RobertWeber1/ThermoControl/board/phase_angle_control/phase_angle_control/lcsc/CC0603JRNPO9BN103.step

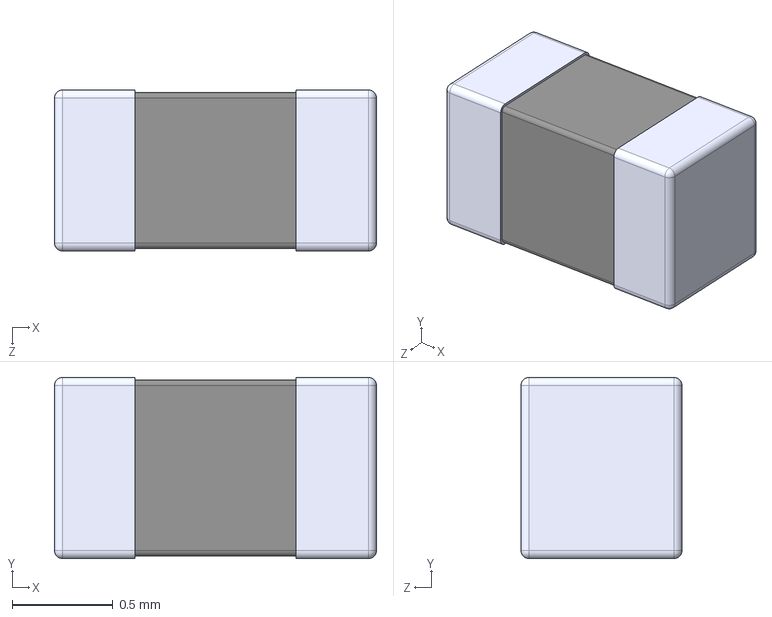
[picture p1: CAD file, 2021-10-10]
board/phase_angle_control/phase_angle_control/lcsc/CC0603JRNPO9BN103.step
1.60 x 0.9 x 0.8 mm
