RobertWeber1/ThermoControl/board/phase_angle_control/phase_angle_control/lcsc/MAX31855KASA_T.step

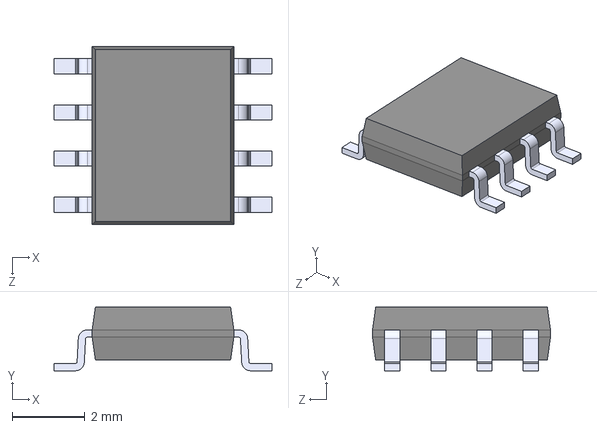
[picture p2: CAD file, 2021-10-10]
board/phase_angle_control/phase_angle_control/lcsc/MAX31855KASA_T.step
6.00 x 1.75 x 4.90 mm
