RobertWeber1/ThermoControl/board/phase_angle_control/phase_angle_control/phase_angle_control.kicad_pcb

## KiCad design board/phase_angle_control/phase_angle_control/phase_angle_control.kicad_pcb (2021-11-07)

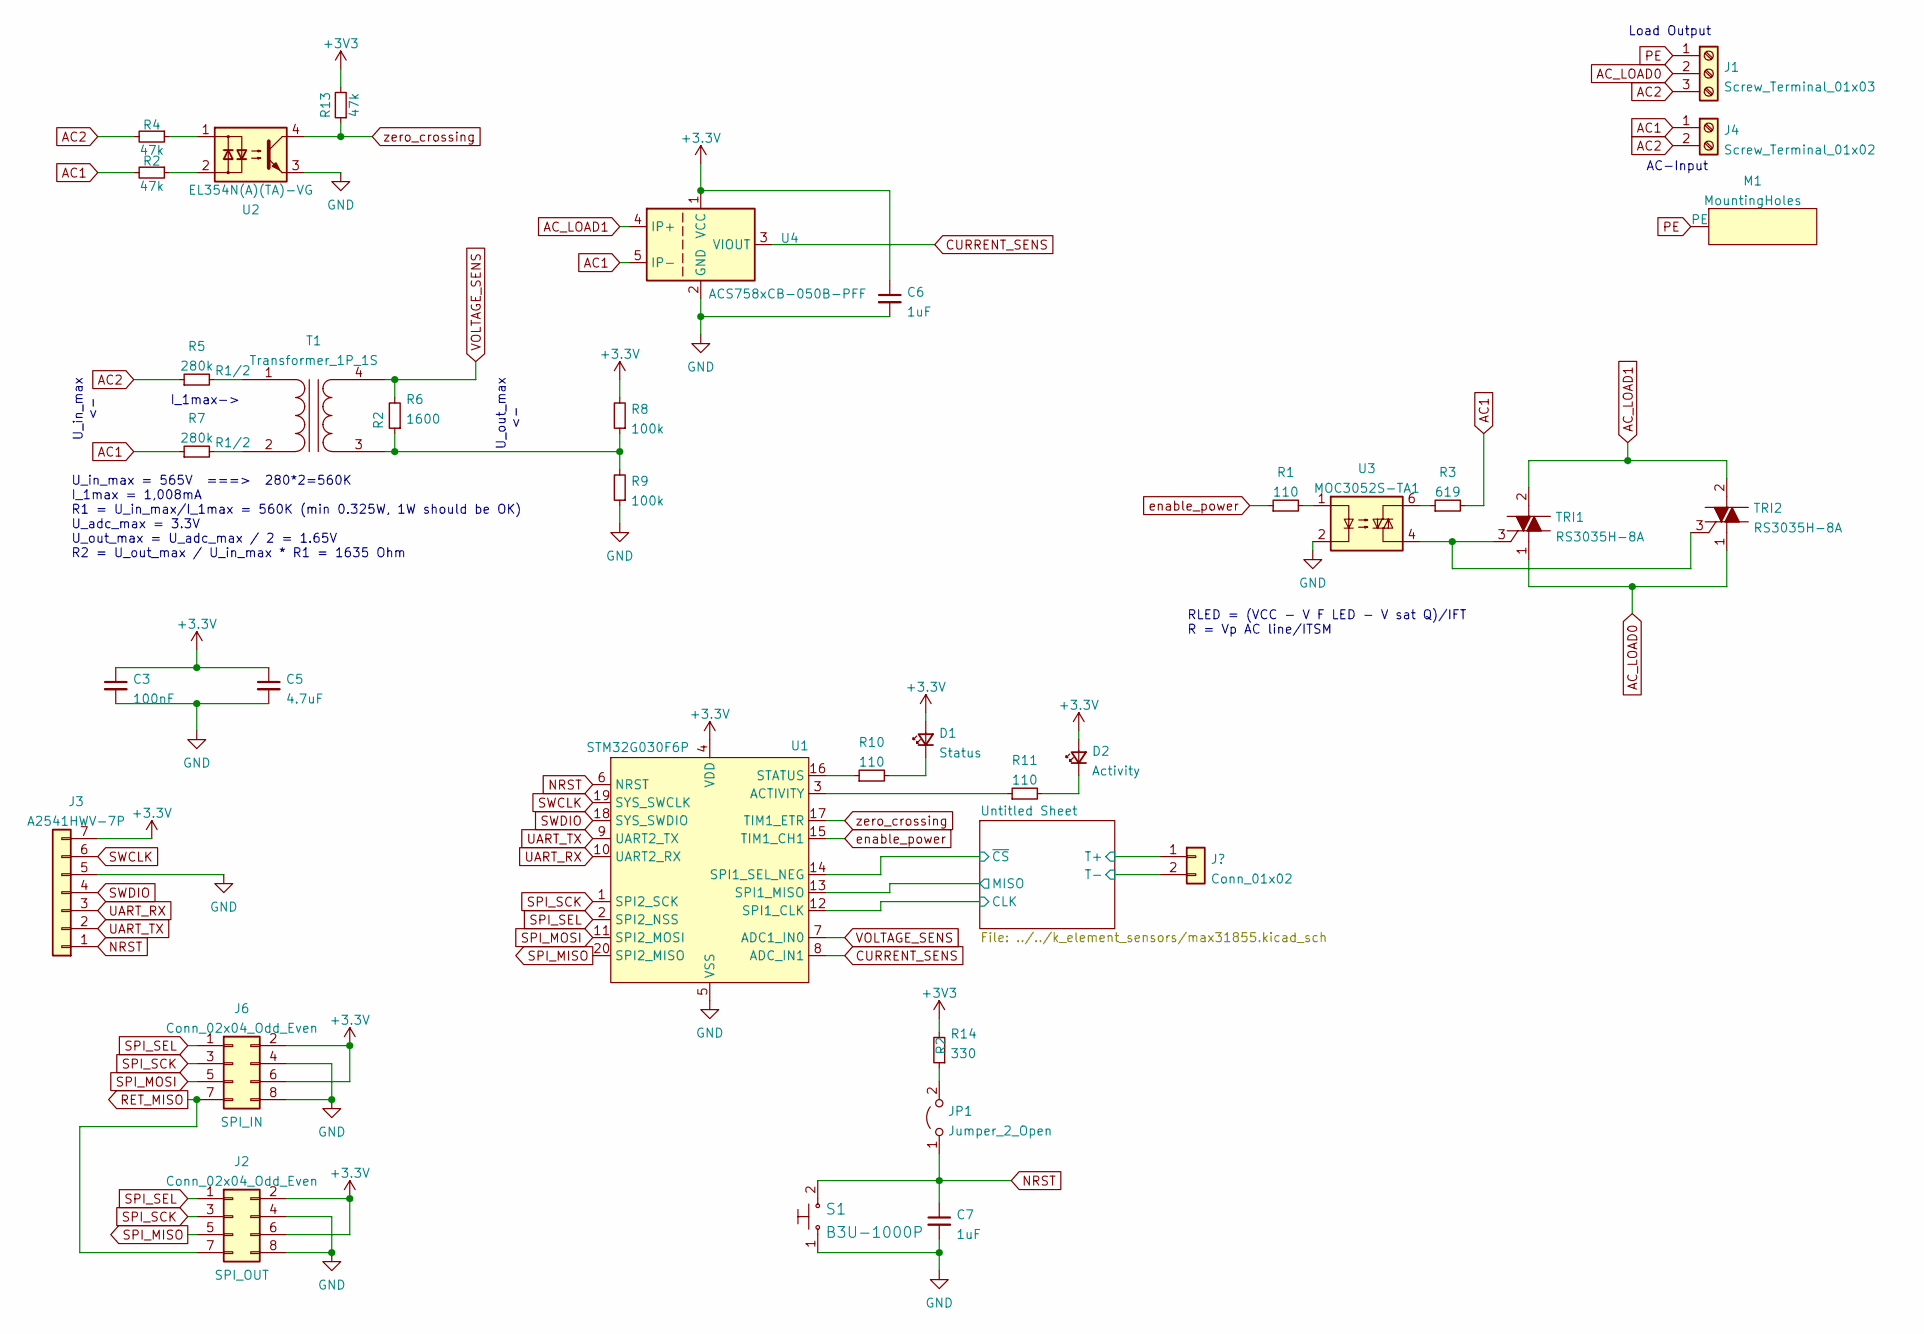
[picture p3: schematic phase_angle_control.kicad_sch]

Parts:
C3: 100nF; C_0603_1608Metric_Pad1.08x0.95mm_HandSolder; LCSC Part# C191538
C5: 4.7uF; C_0603_1608Metric_Pad1.08x0.95mm_HandSolder; LCSC Part# C651001
C6, C7: 1uF; C_0603_1608Metric_Pad1.08x0.95mm_HandSolder; LCSC Part# C393692
D1: Status; LED_0603_1608Metric_Pad1.05x0.95mm_HandSolder; LCSC Part# C273616
D2: Activity; LED_0603_1608Metric_Pad1.05x0.95mm_HandSolder; LCSC Part# C192667
J1: Screw_Terminal_01x03; KF206B-7.5-3P; LCSC Part# C475240
J2, J6: Conn_02x04_Odd_Even; PinHeader_2x04_P2.54mm_Horizontal; LCSC Part# C358706
J3: A2541HWV-7P; PinSocket_1x07_P2.54mm_Vertical; LCSC Part# C225504
J4: Screw_Terminal_01x02; KF206B-7.5-2P; LCSC Part# C475239
JP1: Jumper_2_Open; SolderJumper-2_P1.3mm_Open_RoundedPad1.0x1.5mm
M1: MountingHoles; MountingHolesPE
R1, R10, R11: 110; R_0603_1608Metric_Pad0.98x0.95mm_HandSolder; LCSC Part# C203247
R2: 47k; R_1206_3216Metric_Pad1.30x1.75mm_HandSolder; LCSC Part# C104822
R3: 619; R_1206_3216Metric_Pad1.30x1.75mm_HandSolder; LCSC Part# C247212
R4: 47k; R_1206_3216Metric_Pad1.30x1.75mm_HandSolder
R5, R7: 280k; R_1210_3225Metric_Pad1.30x2.65mm_HandSolder; LCSC Part# C422336
R6: 1600; R_0603_1608Metric_Pad0.98x0.95mm_HandSolder; LCSC Part# C186398
R8, R9: 100k; R_0603_1608Metric_Pad0.98x0.95mm_HandSolder; LCSC Part# C203223
R13: 47k; R_0603_1608Metric_Pad0.98x0.95mm_HandSolder; LCSC Part# C427281
R14: 330; R_0603_1608Metric_Pad0.98x0.95mm_HandSolder; LCSC Part# C186383
S1: B3U-1000P; Switch_Tactile_SMD_B3U-1000P; MPN B3U-1000P; Digi-Key_PN SW1020CT-ND
T1: Transformer_1P_1S; Transformer_ZMPT107-1; LCSC Part# C125191
TRI1, TRI2: RS3035H-8A; TO-220-3; MPN BTA16-600BWRG; LCSC Part# C246522
U1: STM32G030F6P; SSOP-20_4.4x6.5mm_P0.65mm; LCSC Part# C724040
U2: EL354N(A)(TA)-VG; SMDIP-4_W7.62mm; LCSC Part# C146213
U3: MOC3052S-TA1; DIP-6_W8.89mm_SMDSocket_LongPads; LCSC Part# C115471
U4: ACS758xCB-050B-PFF; Allegro_CB_PFF; LCSC Part# C73426

Connections:
/Untitled Sheet/CLK: U1.12 (SPI1_CLK); also elsewhere on the board
/Untitled Sheet/MISO: U1.13 (SPI1_MISO); also elsewhere on the board
/Untitled Sheet/~CS: U1.14 (SPI1_SEL_NEG); also elsewhere on the board
AC1: J4.1, R2.2, R3.2, R7.1, U4.5 (IP-)
AC2: J1.3, J4.2, R4.2, R5.1
AC_LOAD0: J1.2, TRI1.1 (A1), TRI2.1 (A1)
AC_LOAD1: TRI1.2 (A2), TRI2.2 (A2), U4.4 (IP+)
CURRENT_SENS: U1.8 (ADC_IN1), U4.3 (VIOUT)
GND: C3.2, C5.2, C6.2, C7.2, J2.4, J2.8, J3.5, J6.4, J6.8, R9.1, S1.1, U1.5 (VSS), U2.3, U3.2, U4.2 (GND); also elsewhere on the board
NRST: C7.1, J3.1, JP1.1 (A), S1.2, U1.6 (NRST)
unnamed: D1.1 (K), R10.2
unnamed: JP1.2 (B), R14.1
unnamed: R1.2, U3.1
unnamed: R2.1, U2.2
unnamed: R3.1, U3.6
unnamed: R4.1, U2.1
unnamed: R5.2, T1.1 (AA)
unnamed: R6.1, R8.1, R9.2, T1.3 (SA)
unnamed: R7.2, T1.2 (AB)
unnamed: R10.1, U1.16 (STATUS)
unnamed: R11.1, U1.3 (ACTIVITY)
unnamed: D2.1 (K), R11.2
unnamed: TRI1.3 (G), TRI2.3 (G), U3.4
PE: J1.1, M1.1 (PE)
RET_MISO: J2.7, J6.7
SPI_MISO: J2.5, U1.20 (SPI2_MISO)
SPI_MOSI: J6.5, U1.11 (SPI2_MOSI)
SPI_SCK: J2.3, J6.3, U1.1 (SPI2_SCK)
SPI_SEL: J2.1, J6.1, U1.2 (SPI2_NSS)
SWCLK: J3.6, U1.19 (SYS_SWCLK)
SWDIO: J3.4, U1.18 (SYS_SWDIO)
UART_RX: J3.3, U1.10 (UART2_RX)
UART_TX: J3.2, U1.9 (UART2_TX)
VOLTAGE_SENS: R6.2, T1.4 (SB), U1.7 (ADC1_IN0)
enable_power: R1.1, U1.15 (TIM1_CH1)
zero_crossing: R13.1, U1.17 (TIM1_ETR), U2.4

Notes on the sheet:
U_in_max = 565V ===> 280*2=560K I_1max = 1,008mA R1 = U_in_max/I_1max = 560K (min 0.325W, 1W should be OK) U_adc_max = 3.3V U_out_max = U_adc_max / 2 = 1.65V R2 = U_out_max / U_in_max * R1 = 1635 Ohm
U_in_max <-
I_1max->
U_out_max <-
RLED = (VCC - V F LED - V sat Q)/IFT R = Vp AC line/ITSM
Load Output
AC-Input

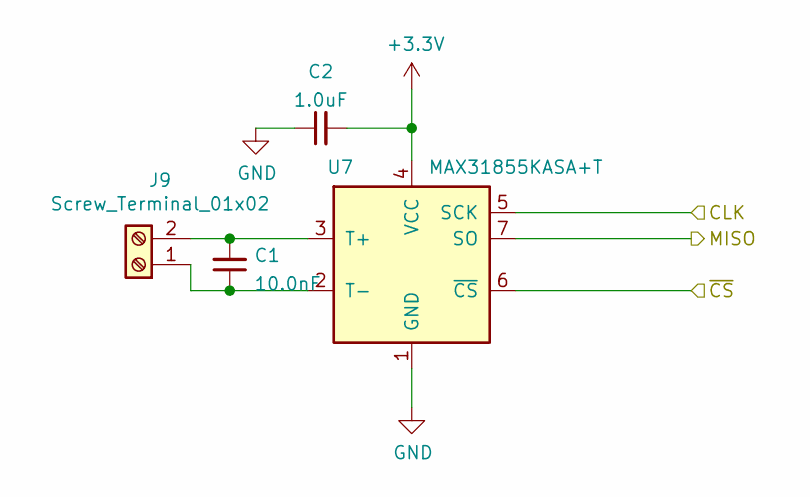
[picture p4: schematic max31855.kicad_sch]

Parts:
C1: 10.0nF; C_0603_1608Metric_Pad1.08x0.95mm_HandSolder
C2: 1.0uF; C_0603_1608Metric_Pad1.08x0.95mm_HandSolder
J9: Screw_Terminal_01x02; con_A123829-ND‎; LCSC Part # C474892
U7: MAX31855KASA+T; SOIC-8_3.9x4.9mm_P1.27mm; LCSC Part # C52028

Connections:
/Untitled Sheet/CLK: U7.5 (SCK); also elsewhere on the board
/Untitled Sheet/MISO: U7.7 (SO); also elsewhere on the board
/Untitled Sheet/~CS: U7.6 (~CS); also elsewhere on the board
GND: C2.1, U7.1 (GND); also elsewhere on the board
unnamed: C1.1, J9.1, U7.2 (T-)
unnamed: C1.2, J9.2, U7.3 (T+)

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
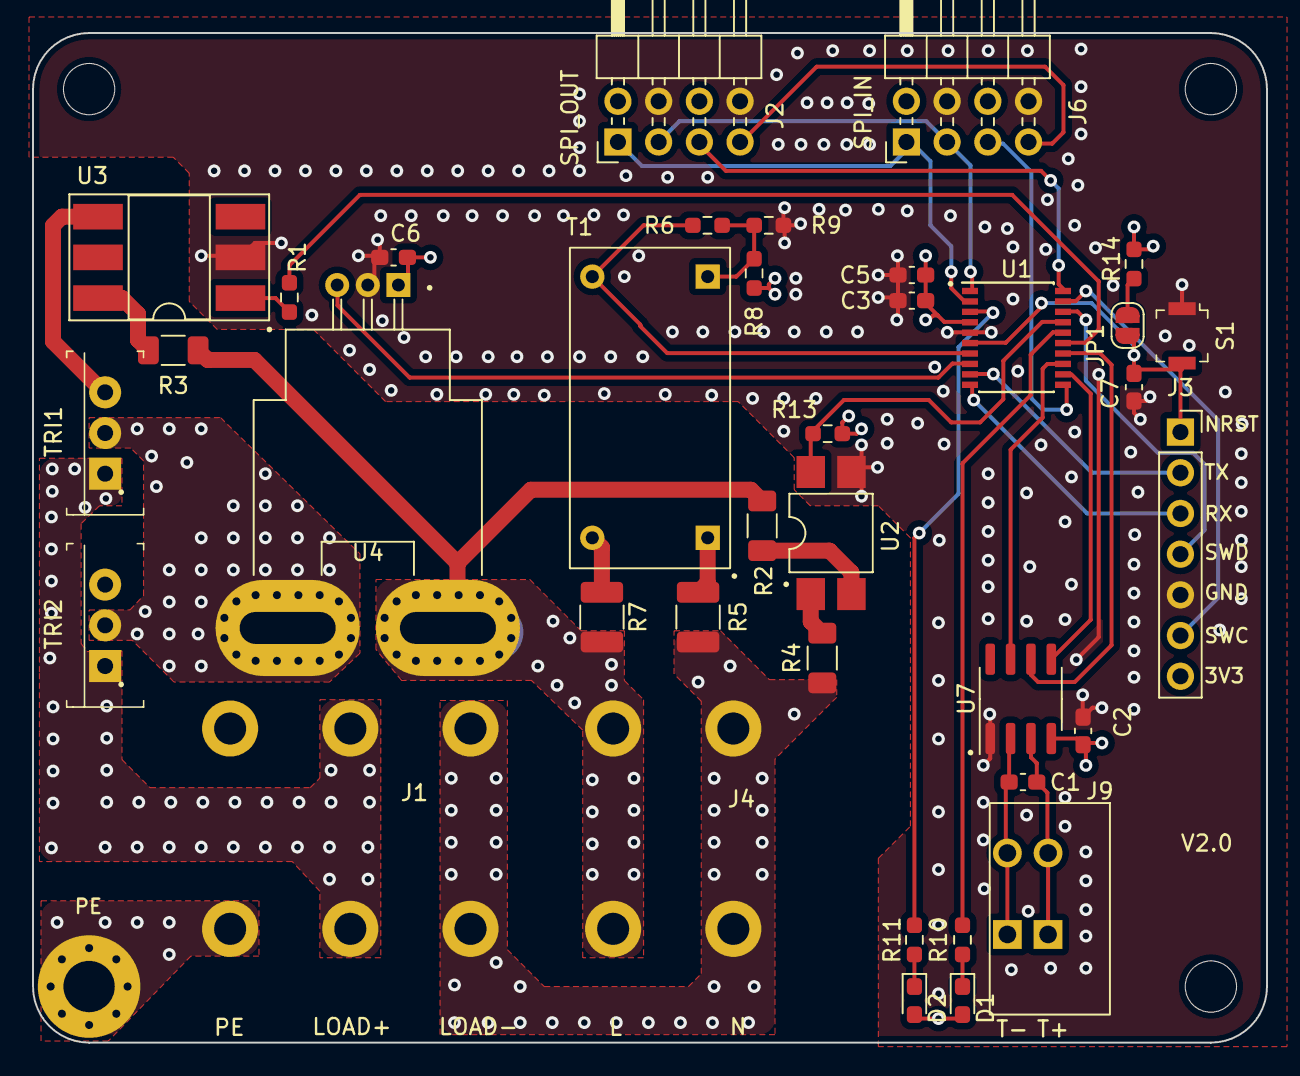
[picture p5: board phase_angle_control.kicad_pcb from above]

Board: 4 copper layers, 77.0 x 63.0 mm, 38 parts (0 on the bottom side), 39 nets.
