RobertWeber1/ThermoControl/board/brain_board/brain_board.kicad_pcb

## KiCad design board/brain_board/brain_board.kicad_pcb (2021-11-07)

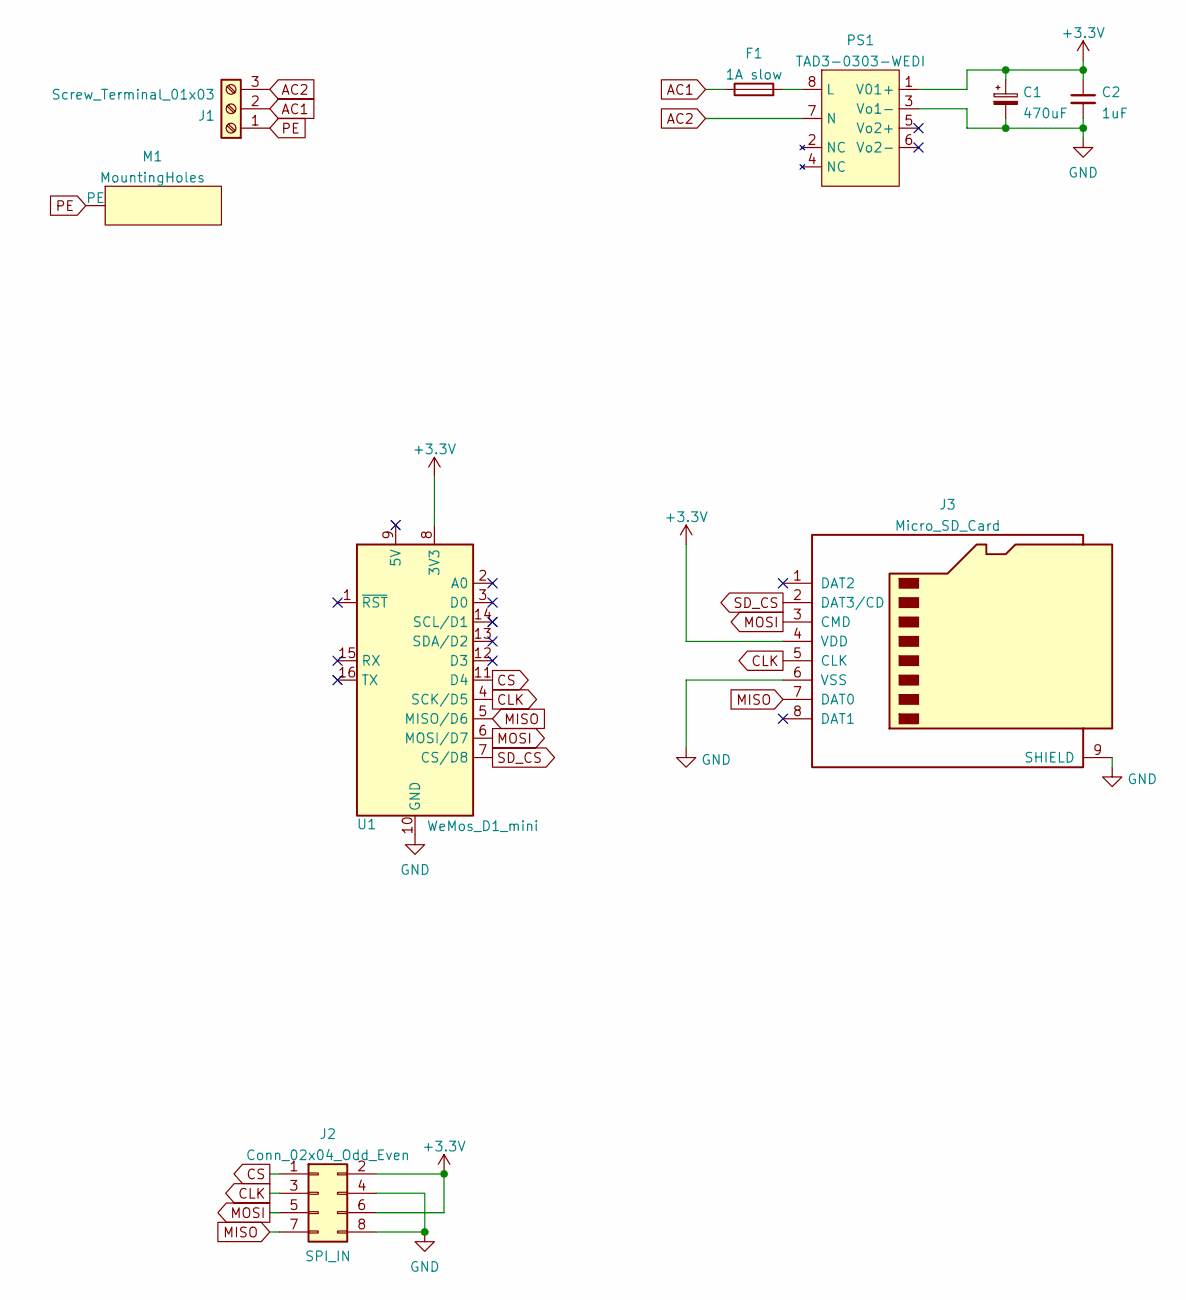
[picture p6: schematic brain_board.kicad_sch]

Parts:
C1: 470uF; CP_Radial_D8.0mm_P3.50mm; LCSC Part# C840136
C2: 1uF; C_Disc_D4.3mm_W1.9mm_P5.00mm; LCSC Part# C444742
F1: 1A slow; Fuse_2410; LCSC Part# C136380
J1: Screw_Terminal_01x03; KF206B-7.5-3P; LCSC Part# C475240
J2: Conn_02x04_Odd_Even; PinHeader_2x04_P2.54mm_Horizontal; LCSC Part# C358706
J3: Micro_SD_Card; micro_sd_slot; LCSC Part# C341095
M1: MountingHoles; MountingHolesPE
PS1: TAD3-0303-WEDI; LCSC Part# C695893
U1: WeMos_D1_mini; WEMOS_D1_mini_light

Connections:
+3V3: C1.1, C2.1, J2.2, J2.6, J3.4 (VDD), PS1.1 (V01+), U1.8 (3V3)
AC1: F1.1, J1.2
AC2: J1.3, PS1.7 (N)
CLK: J2.3, J3.5 (CLK), U1.4 (SCK/D5)
CS: J2.1, U1.11 (D4)
GND: C1.2, C2.2, J2.4, J2.8, J3.6 (VSS), J3.9 (SHIELD), PS1.3 (Vo1-), U1.10 (GND)
MISO: J2.7, J3.7 (DAT0), U1.5 (MISO/D6)
MOSI: J2.5, J3.3 (CMD), U1.6 (MOSI/D7)
unnamed: F1.2, PS1.8 (L)
PE: J1.1, M1.1 (PE)
SD_CS: J3.2 (DAT3/CD), U1.7 (CS/D8)

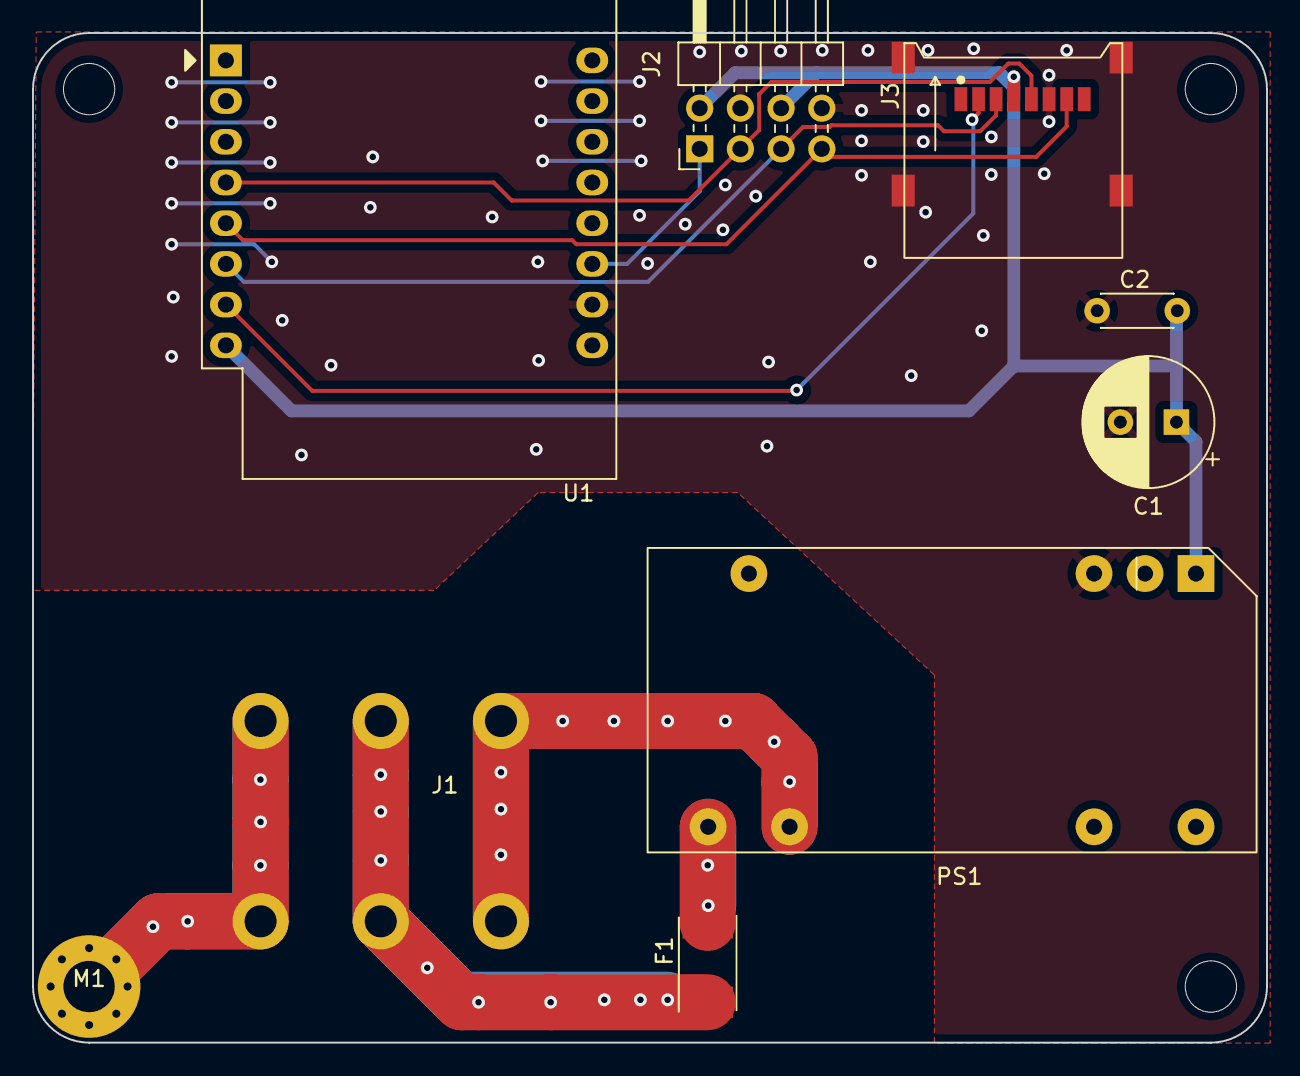
[picture p7: board brain_board.kicad_pcb from above]

Board: 2 copper layers, 77.0 x 63.0 mm, 9 parts (0 on the bottom side), 11 nets.
