RobertWeber1/ThermoControl/board/k_element_sensors/Thermo.kicad_pcb

## KiCad design board/k_element_sensors/Thermo.kicad_pcb (2021-05-06)

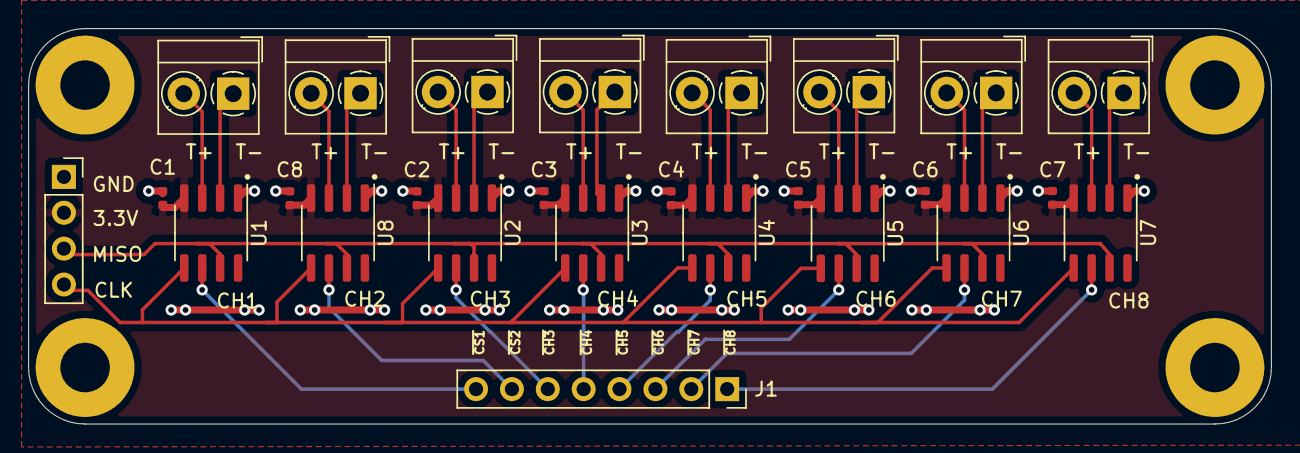
[picture p8: board Thermo.kicad_pcb from above]

Board: 2 copper layers, 88.0 x 28.0 mm, 27 parts (0 on the bottom side), 28 nets.

Parts:
C1, C2, C3, C4, C5, C6, C7, C8: 0402_1.0uF__105_10%_25V; C_0402_1005Metric
H1: MountingHoles; MountingHole_pattern
J1: Conn_01x08; PinSocket_1x08_P2.54mm_Vertical
J2: Conn_01x04; PinSocket_1x04_P2.54mm_Vertical
J3, J4, J5, J6, J7, J8, J9, J10: Screw_Terminal_01x02; TerminalBlock_MetzConnect_Type059_RT06302HBWC_1x02_P3.50mm_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
U1, U2, U3, U4, U5, U6, U7, U8: MAX31855KASA+T; SOIC-8_3.9x4.9mm_P1.27mm

Connections:
+3V3: C1.2, C2.2, C3.2, C4.2, C5.2, C6.2, C7.2, C8.2, J2.2, U1.4, U2.4, U3.4, U4.4, U5.4, U6.4, U7.4, U8.4
/max31855/CLK: J2.4, U1.5, U2.5, U3.5, U4.5, U5.5, U6.5, U7.5, U8.5
/max31855/MISO: J2.3, U1.7, U2.7, U3.7, U4.7, U5.7, U6.7, U7.7, U8.7
/max31855/~CS~: J1.8, U1.6
/sheet606BA990/~CS~: J1.7, U8.6
/sheet606BAB02/~CS~: J1.6, U2.6
/sheet606BABA0/~CS~: J1.5, U3.6
/sheet606BAC16/~CS~: J1.4, U4.6
/sheet606BAC84/~CS~: J1.3, U5.6
/sheet606BACD6/~CS~: J1.2, U6.6
/sheet606BAD28/~CS~: J1.1, U7.6
GND: C1.1, C2.1, C3.1, C4.1, C5.1, C6.1, C7.1, C8.1, J2.1, U1.1, U2.1, U3.1, U4.1, U5.1, U6.1, U7.1, U8.1
unnamed: J3.1, U1.2
unnamed: J3.2, U1.3
unnamed: J4.1, U2.2
unnamed: J4.2, U2.3
unnamed: J5.1, U3.2
unnamed: J5.2, U3.3
unnamed: J6.1, U4.2
unnamed: J6.2, U4.3
unnamed: J7.1, U5.2
unnamed: J7.2, U5.3
unnamed: J8.1, U6.2
unnamed: J8.2, U6.3
unnamed: J9.1, U7.2
unnamed: J9.2, U7.3
unnamed: J10.1, U8.2
unnamed: J10.2, U8.3
