RobertWeber1/ThermoControl/software/hal/hal.ioc

Mcu.UserName=STM32G030F6Px
PA0.Signal=ADC1_IN0
PA1.Signal=ADC1_IN1
PA13.Signal=SYS_SWDIO
PA14-BOOT0.Signal=SYS_SWCLK
PA2.Signal=USART2_TX
PA3.Signal=USART2_RX
PA4.Signal=SPI2_MOSI
PA5.Signal=SPI1_SCK
PA6.Signal=SPI1_MISO
PA7.GPIO_Label=SPI1_SEL_NEG
PA7.Signal=GPIO_Output
PA8.GPIO_Label=ENABLE_POWER
PA8.Signal=GPIO_Output
PB6.Signal=SPI2_MISO
PB8.Signal=SPI2_SCK
PB9.Signal=SPI2_NSS
