RobertWeber1/ThermoControl/software/hal/Core/Inc/main.h

#define ACTIVITY_LED_Pin GPIO_PIN_15
#define ACTIVITY_LED_GPIO_Port GPIOC
#define SPI1_SEL_NEG_Pin GPIO_PIN_7
#define SPI1_SEL_NEG_GPIO_Port GPIOA
#define ENABLE_POWER_Pin GPIO_PIN_8
#define ENABLE_POWER_GPIO_Port GPIOA
#define STATUS_LED_Pin GPIO_PIN_11
#define STATUS_LED_GPIO_Port GPIOA
