RobertWeber1/ThermoControl/(commit log)

2021-08-11 Restructure repo
    [Thermo.kicad_pcb, Thermo.sch, max31855.sch]
2021-08-27 Add phase angle controller board
    [phase_angle_control.kicad_pcb, phase_angle_control.kicad_sch]
2021-09-15 Working UART and SPI
2021-09-23 Add Arduino skatch
2021-09-23 Add SPI communicaion master test
2021-09-24 Implement new SPI data transfer
2021-10-04 Redesign phase angle contrller board for more current throughput
    [phase_angle_control.kicad_pcb, phase_angle_control.kicad_sch]
2021-10-10 Update phase-angle-control-board to handle more current
    [CC0603JRNPO9BN103.step, MAX31855KASA_T.step, max31855.kicad_sch, phase_angle_control.kicad_pcb, phase_angle_control.kicad_sch]
2021-10-10 Add base board for ESP8266
    [brain_board.kicad_pcb, brain_board.kicad_sch]
2021-10-10 Move arduino skatch
2021-10-10 Basic SPI communication between ESP8266 and PACs
2021-10-10 Start to improve spi abstraction
2021-10-20 Try to fix sd-card storage
    [control.h, sketch_jul15a.ino]
2021-10-20 Increase spi transaction speed
2021-10-20 Start to implement SPI abstraction layer
2021-10-20 Split spi abstaction into multiple files
2021-11-07 WIP: Try cmake arduino
2021-11-07 Fix SD-Slot pin alignment
    [brain_board.kicad_pcb, brain_board.kicad_sch]
2021-11-07 Fix LED rotation
    [max31855.kicad_sch, phase_angle_control.kicad_pcb, phase_angle_control.kicad_sch]
2021-11-07 HAL: Add LED abstraction
